Sanmugavel1/SourceSense-atomQUEST2026/cad/renders/SS_Render_Lid_Closeup.png

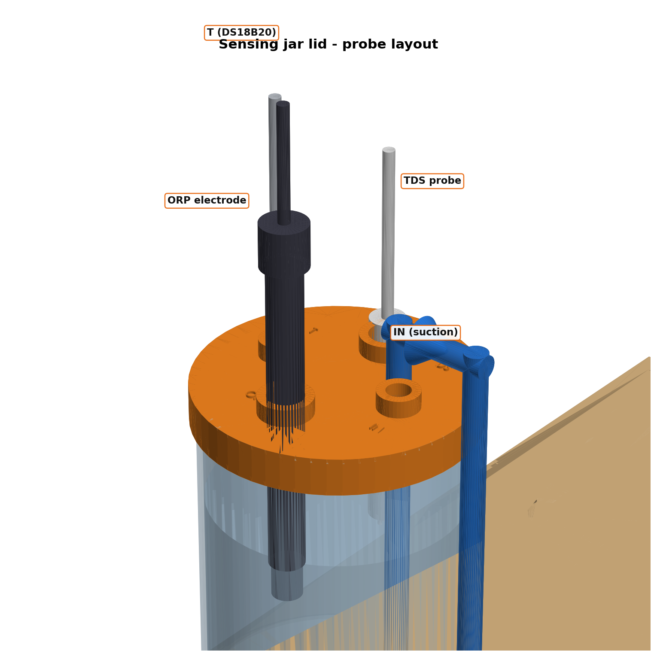
cad/renders/SS_Render_Lid_Closeup.png
