Sanmugavel1/SourceSense-atomQUEST2026/cad/renders/SS_Render_Overall_Iso.png

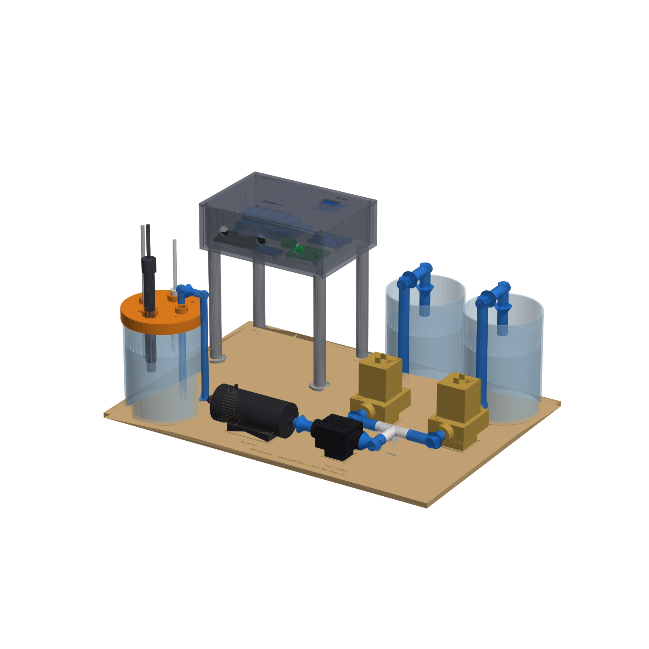
cad/renders/SS_Render_Overall_Iso.png
