Sanmugavel1/SourceSense-atomQUEST2026/cad/renders/SS_Render_Top.png

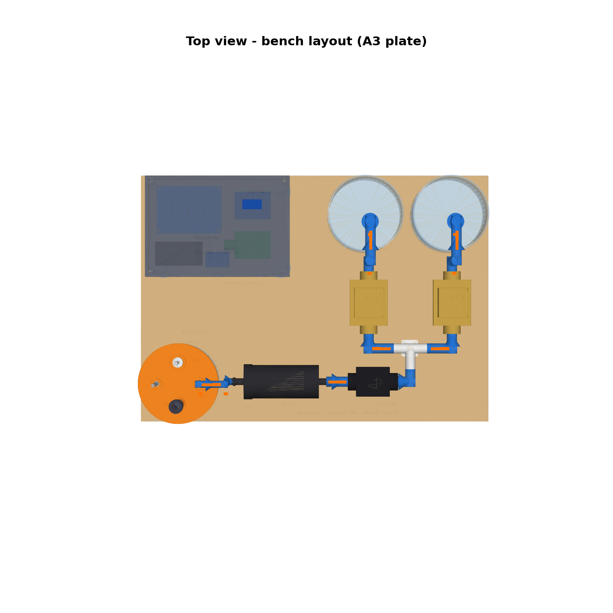
cad/renders/SS_Render_Top.png
