Sanmugavel1/SourceSense-atomQUEST2026/cad/renders/SS_Render_Water_Path.png

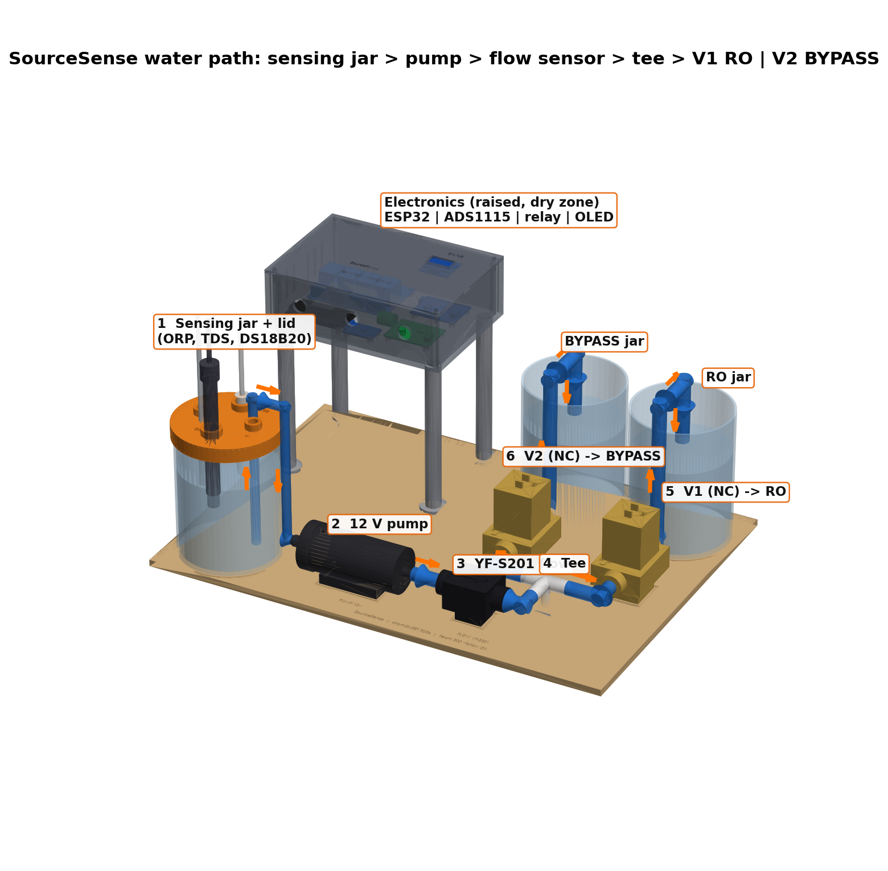
cad/renders/SS_Render_Water_Path.png
