Sanmugavel1/SourceSense-atomQUEST2026/cad/assemblies/SS_11_Assembly_Exploded.SLDASM

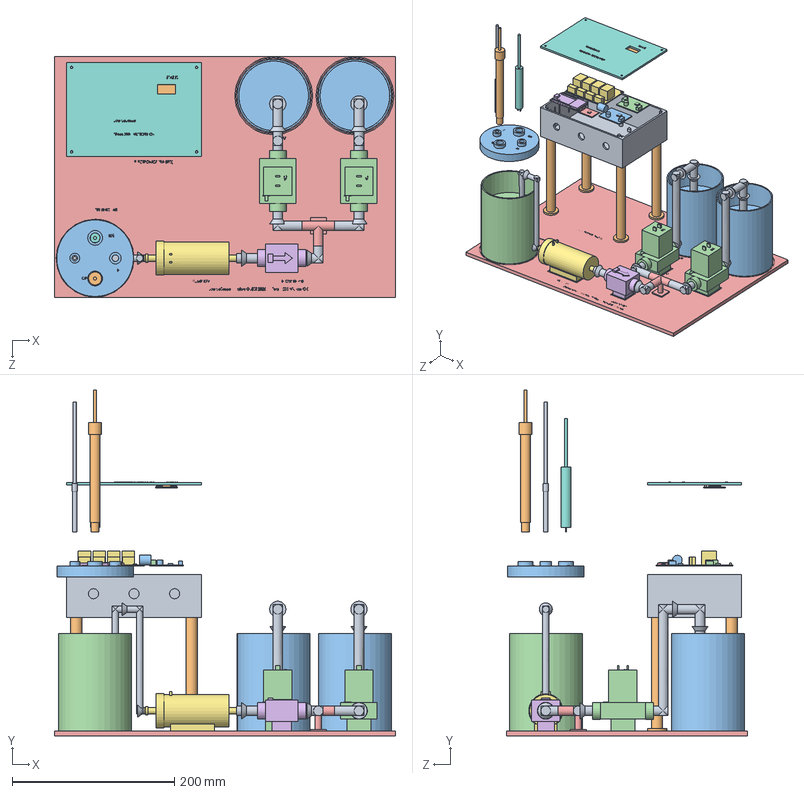
[picture p11: CAD file, 2026-11-04]
cad/assemblies/SS_11_Assembly_Exploded.SLDASM
420.0 x 426.0 x 297.0 mm
SS_09_Base_Plate_A3
SS_00_Sensing_Jar
SS_01_Jar_Lid
SS_11_ORP_Electrode
SS_13_DS18B20_Probe
SS_12_TDS_Probe
SS_02_Pump_12V
SS_03_Flow_Sensor_YF-S201
SS_04_Tee_Connector
SS_05_Solenoid_Valve_NC x 2
SS_06_Output_Jar x 2
SS_08_Standoff_Leg x 4
SS_07_Electronics_Enclosure
SS_07b_Enclosure_Lid
SS_16_Relay_Module_4ch
SS_14_ESP32_DevKit_V1
SS_15_ADS1115_Module
SS_18_TDS_Signal_Board
SS_19_ORP_Signal_Board
SS_17_OLED_096_I2C
SS_20_Water_Tubing
