Sanmugavel1/SourceSense-atomQUEST2026/cad/parts/SS_05_Solenoid_Valve_NC.SLDPRT

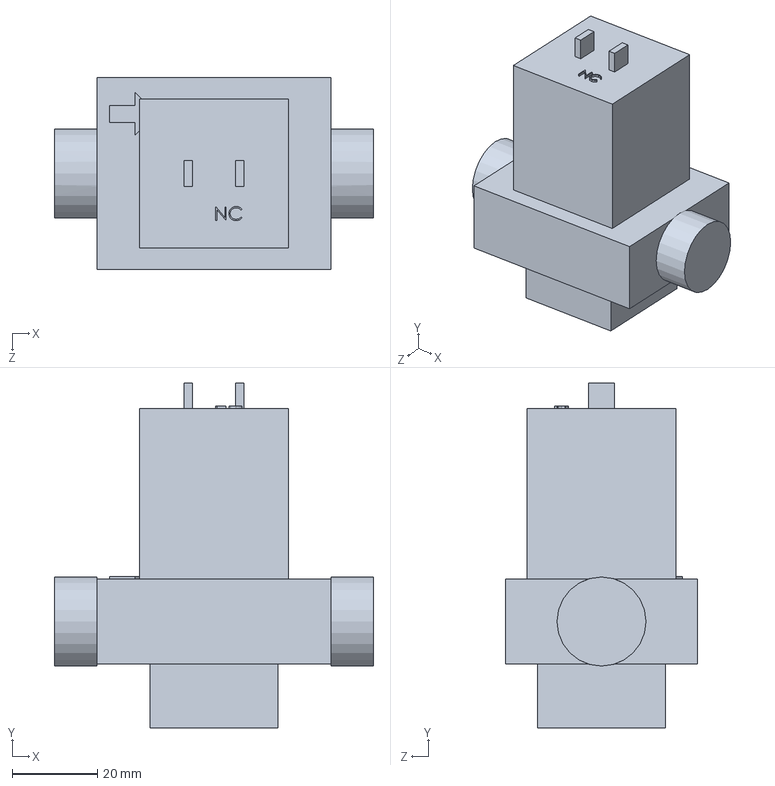
[picture p12: CAD file, 2026-11-04]
cad/parts/SS_05_Solenoid_Valve_NC.SLDPRT
75.0 x 81.0 x 45.0 mm
