Sanmugavel1/SourceSense-atomQUEST2026/cad/parts/SS_04_Tee_Connector.SLDPRT

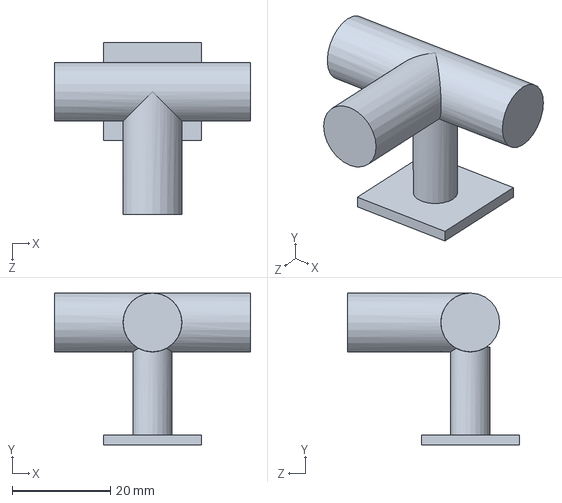
[picture p13: CAD file, 2026-11-04]
cad/parts/SS_04_Tee_Connector.SLDPRT
40.0 x 31.0 x 35.0 mm
