Sanmugavel1/SourceSense-atomQUEST2026/cad/parts/SS_07b_Enclosure_Lid.SLDPRT

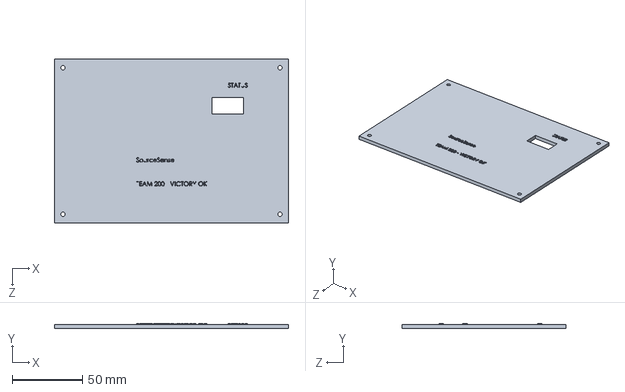
[picture p14: CAD file, 2026-11-04]
cad/parts/SS_07b_Enclosure_Lid.SLDPRT
166.0 x 3.80 x 116.0 mm
