Sanmugavel1/SourceSense-atomQUEST2026/cad/parts/SS_20_Water_Tubing.SLDPRT

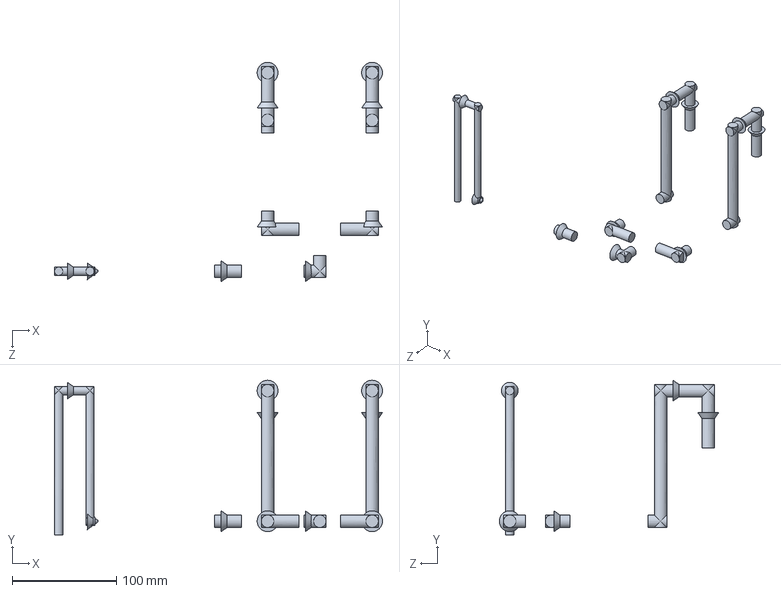
[picture p15: CAD file, 2026-11-04]
cad/parts/SS_20_Water_Tubing.SLDPRT
314.0 x 148.0 x 210.0 mm
