Sanmugavel1/SourceSense-atomQUEST2026/cad/parts/SS_08_Standoff_Leg.SLDPRT

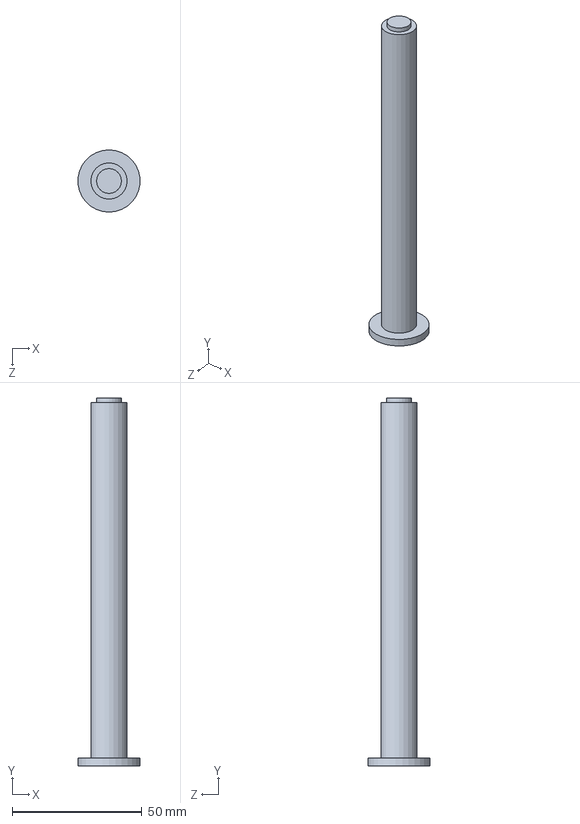
[picture p16: CAD file, 2026-11-04]
cad/parts/SS_08_Standoff_Leg.SLDPRT
23.9 x 141.8 x 24.0 mm
