Sanmugavel1/SourceSense-atomQUEST2026/cad/parts/SS_15_ADS1115_Module.SLDPRT

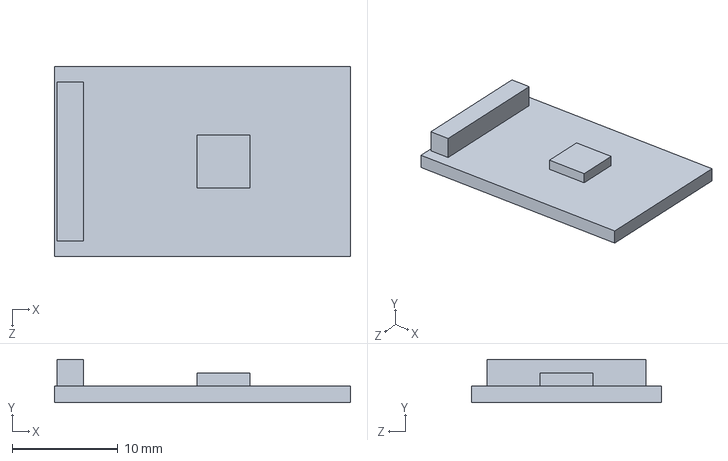
[picture p17: CAD file, 2026-11-04]
cad/parts/SS_15_ADS1115_Module.SLDPRT
28.0 x 4.10 x 18.0 mm
