Sanmugavel1/SourceSense-atomQUEST2026/cad/parts/SS_11_ORP_Electrode.SLDPRT

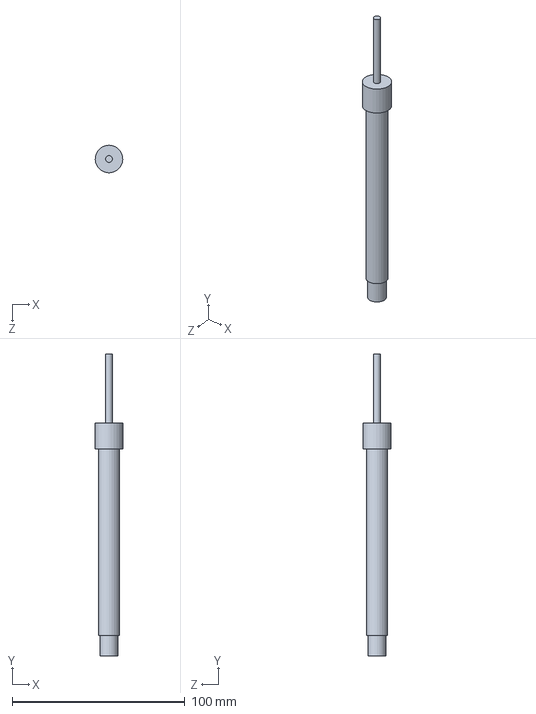
[picture p18: CAD file, 2026-11-04]
cad/parts/SS_11_ORP_Electrode.SLDPRT
16.0 x 175.0 x 16.0 mm
