Sanmugavel1/SourceSense-atomQUEST2026/cad/parts/SS_19_ORP_Signal_Board.SLDPRT

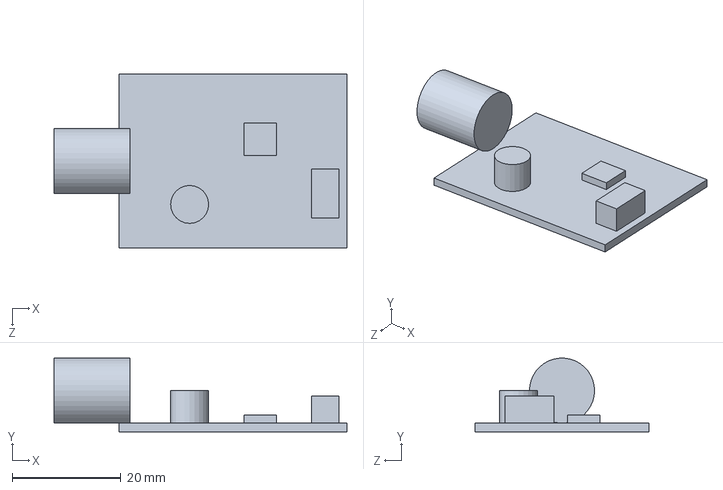
[picture p19: CAD file, 2026-11-04]
cad/parts/SS_19_ORP_Signal_Board.SLDPRT
54.0 x 13.6 x 32.0 mm
