Sanmugavel1/SourceSense-atomQUEST2026/cad/parts/SS_16_Relay_Module_4ch.SLDPRT

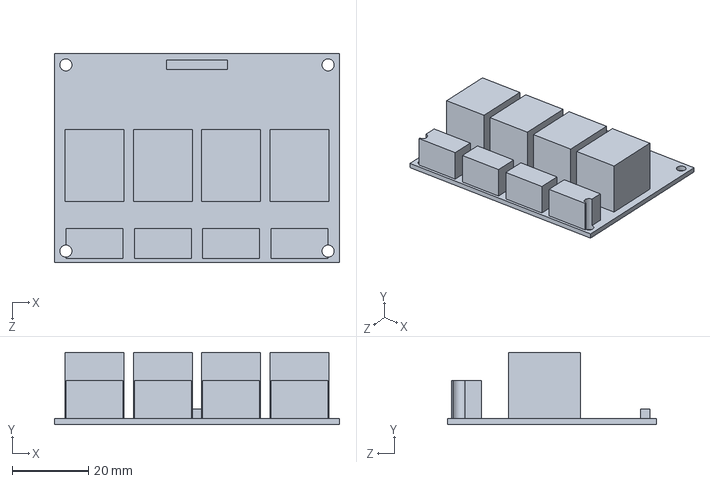
[picture p20: CAD file, 2026-11-04]
cad/parts/SS_16_Relay_Module_4ch.SLDPRT
75.0 x 19.0 x 55.0 mm
