Sanmugavel1/SourceSense-atomQUEST2026/cad/parts/SS_18_TDS_Signal_Board.SLDPRT

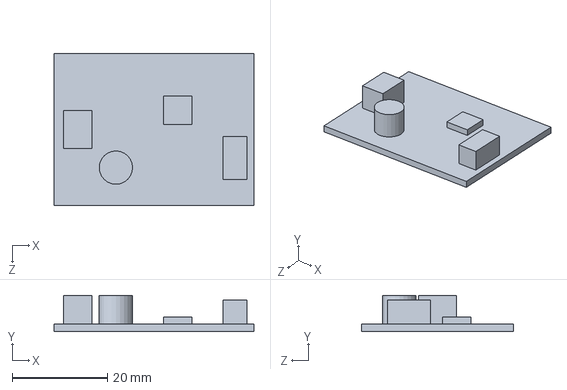
[picture p21: CAD file, 2026-11-04]
cad/parts/SS_18_TDS_Signal_Board.SLDPRT
42.0 x 7.60 x 32.0 mm
