Sanmugavel1/SourceSense-atomQUEST2026/cad/parts/SS_12_TDS_Probe.SLDPRT

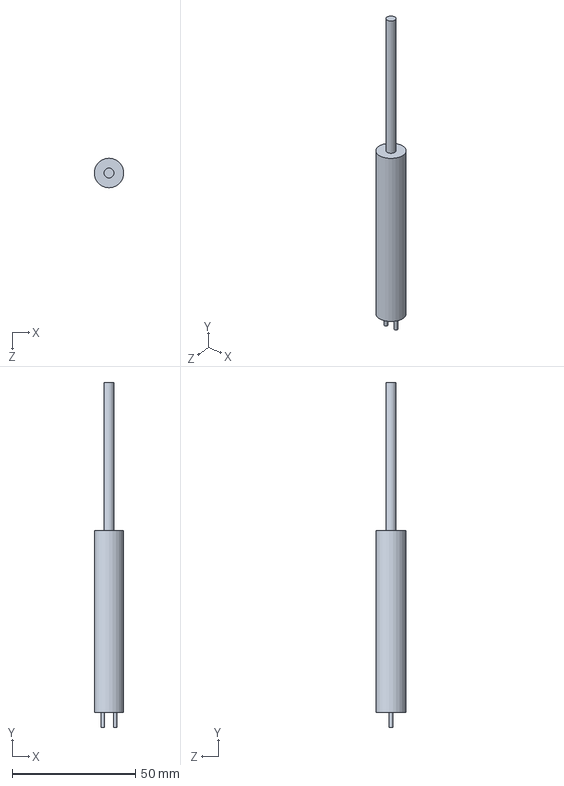
[picture p22: CAD file, 2026-11-04]
cad/parts/SS_12_TDS_Probe.SLDPRT
11.9 x 140.0 x 12.0 mm
