Sanmugavel1/SourceSense-atomQUEST2026/cad/parts/SS_07_Electronics_Enclosure.SLDPRT

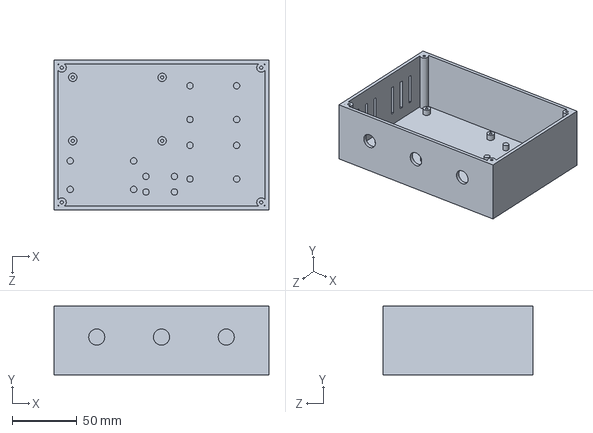
[picture p23: CAD file, 2026-11-04]
cad/parts/SS_07_Electronics_Enclosure.SLDPRT
166.0 x 53.0 x 116.0 mm
