Sanmugavel1/SourceSense-atomQUEST2026/cad/parts/SS_09_Base_Plate_A3.SLDPRT

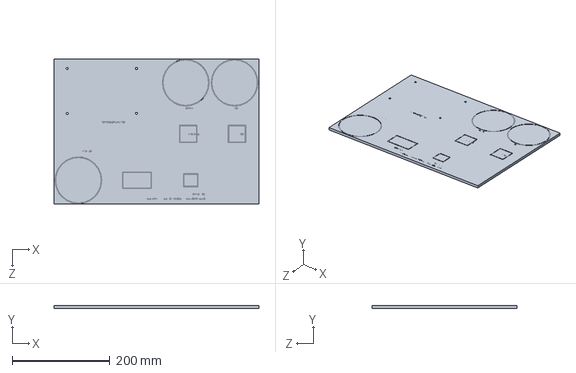
[picture p24: CAD file, 2026-11-04]
cad/parts/SS_09_Base_Plate_A3.SLDPRT
420.0 x 6.00 x 297.0 mm
