Sanmugavel1/SourceSense-atomQUEST2026/cad/parts/SS_06_Output_Jar.SLDPRT

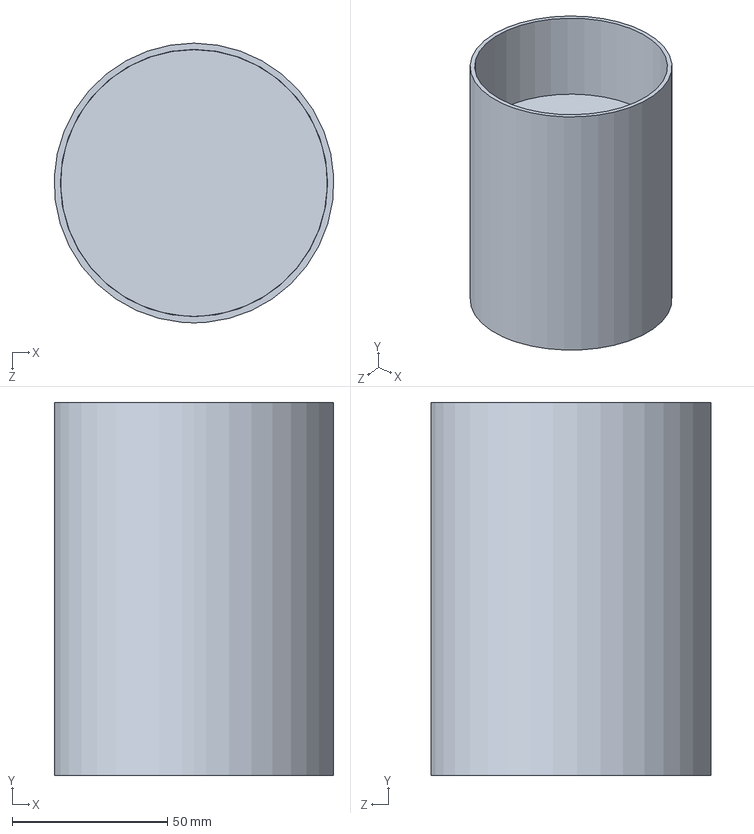
[picture p25: CAD file, 2026-11-04]
cad/parts/SS_06_Output_Jar.SLDPRT
89.9 x 120.0 x 90.0 mm
