Sanmugavel1/SourceSense-atomQUEST2026/cad/parts/SS_14_ESP32_DevKit_V1.SLDPRT

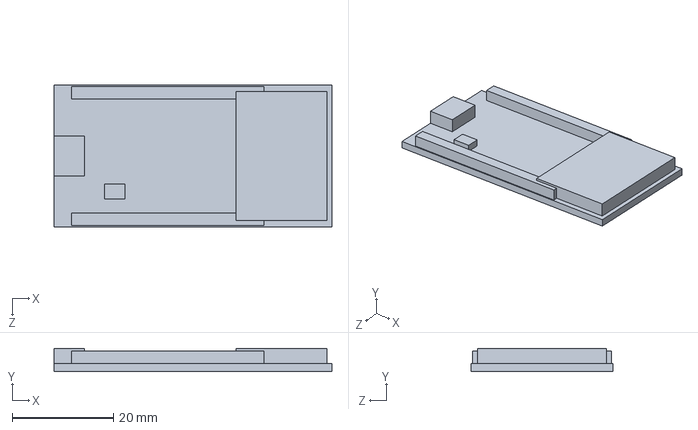
[picture p26: CAD file, 2026-11-04]
cad/parts/SS_14_ESP32_DevKit_V1.SLDPRT
55.0 x 4.60 x 28.0 mm
