Sanmugavel1/SourceSense-atomQUEST2026/cad/parts/SS_01_Jar_Lid.SLDPRT

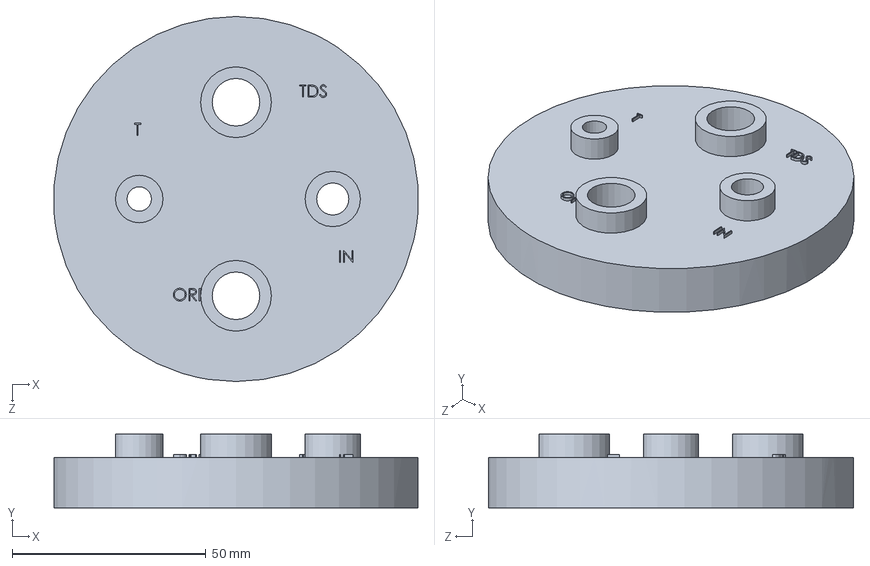
[picture p27: CAD file, 2026-11-04]
cad/parts/SS_01_Jar_Lid.SLDPRT
94.0 x 19.0 x 94.3 mm
