Sanmugavel1/SourceSense-atomQUEST2026/cad/parts/SS_13_DS18B20_Probe.SLDPRT

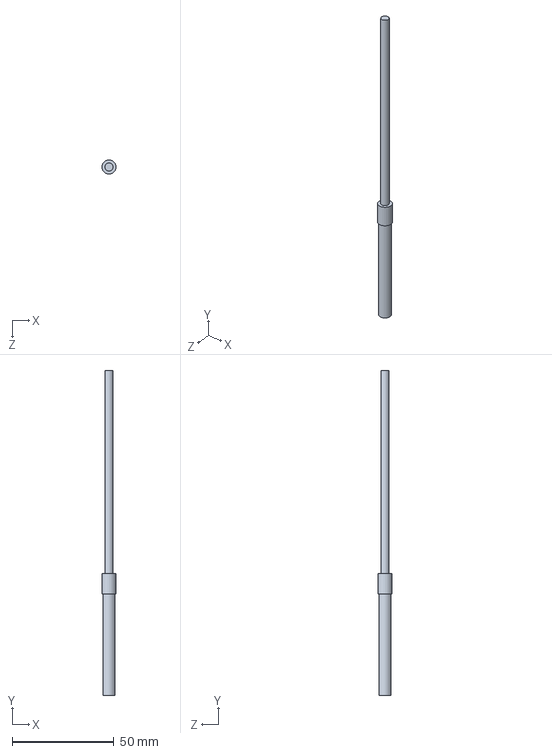
[picture p28: CAD file, 2026-11-04]
cad/parts/SS_13_DS18B20_Probe.SLDPRT
7.00 x 160.0 x 7.00 mm
