Sanmugavel1/SourceSense-atomQUEST2026/cad/parts/SS_03_Flow_Sensor_YF-S201.SLDPRT

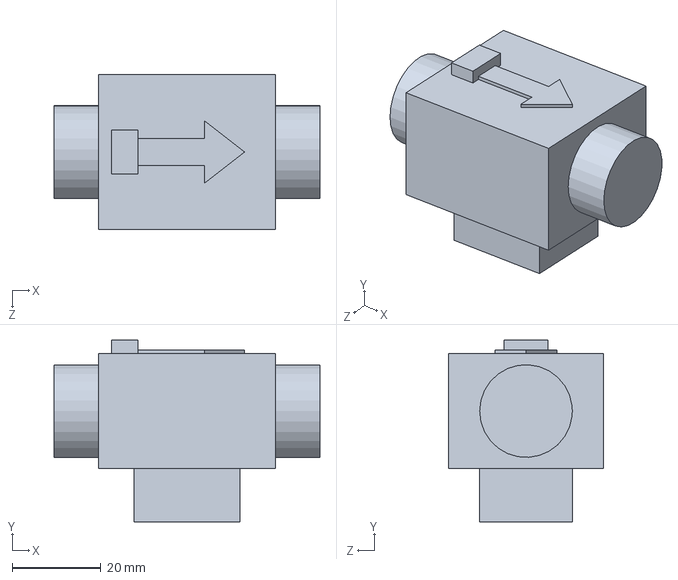
[picture p29: CAD file, 2026-11-04]
cad/parts/SS_03_Flow_Sensor_YF-S201.SLDPRT
60.0 x 41.0 x 35.0 mm
