Sanmugavel1/SourceSense-atomQUEST2026/cad/parts/SS_02_Pump_12V.SLDPRT

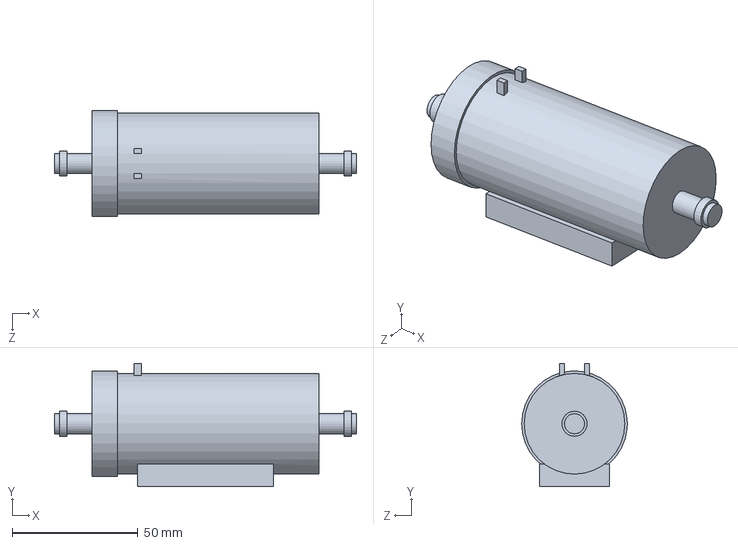
[picture p30: CAD file, 2026-11-04]
cad/parts/SS_02_Pump_12V.SLDPRT
120.0 x 49.0 x 42.0 mm
