Sanmugavel1/SourceSense-atomQUEST2026/cad/parts/SS_17_OLED_096_I2C.SLDPRT

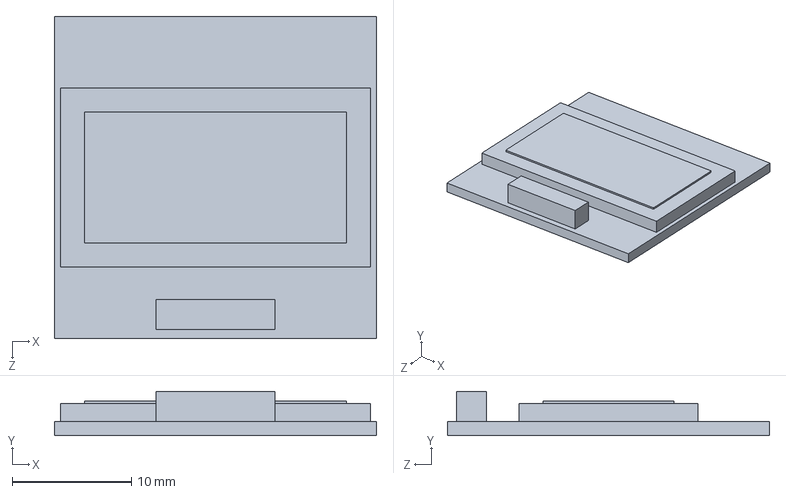
[picture p31: CAD file, 2026-11-04]
cad/parts/SS_17_OLED_096_I2C.SLDPRT
27.0 x 3.70 x 27.0 mm
