Sanmugavel1/SourceSense-atomQUEST2026/(list of files, cad)

Other CAD files:
cad/SS_10_Assembly.step
cad/parts/SS_00_Sensing_Jar.SLDPRT
cad/drawings/SS_10_Assembly.SLDDRW
cad/stl/SS_00_Sensing_Jar.STL
cad/stl/SS_01_Jar_Lid.STL
cad/stl/SS_02_Pump_12V.STL
cad/stl/SS_03_Flow_Sensor_YF-S201.STL
cad/stl/SS_04_Tee_Connector.STL
cad/stl/SS_05_Solenoid_Valve_NC.STL
cad/stl/SS_06_Output_Jar.STL
cad/stl/SS_07_Electronics_Enclosure.STL
cad/stl/SS_07b_Enclosure_Lid.STL
cad/stl/SS_08_Standoff_Leg.STL
cad/stl/SS_09_Base_Plate_A3.STL
cad/stl/SS_11_ORP_Electrode.STL
cad/stl/SS_12_TDS_Probe.STL
cad/stl/SS_13_DS18B20_Probe.STL
cad/stl/SS_14_ESP32_DevKit_V1.STL
cad/stl/SS_15_ADS1115_Module.STL
cad/stl/SS_16_Relay_Module_4ch.STL
cad/stl/SS_17_OLED_096_I2C.STL
cad/stl/SS_18_TDS_Signal_Board.STL
cad/stl/SS_19_ORP_Signal_Board.STL
cad/stl/SS_20_Water_Tubing.STL
