Sanmugavel1/SourceSense-atomQUEST2026/cad/drawings/SS_10_Assembly.pdf

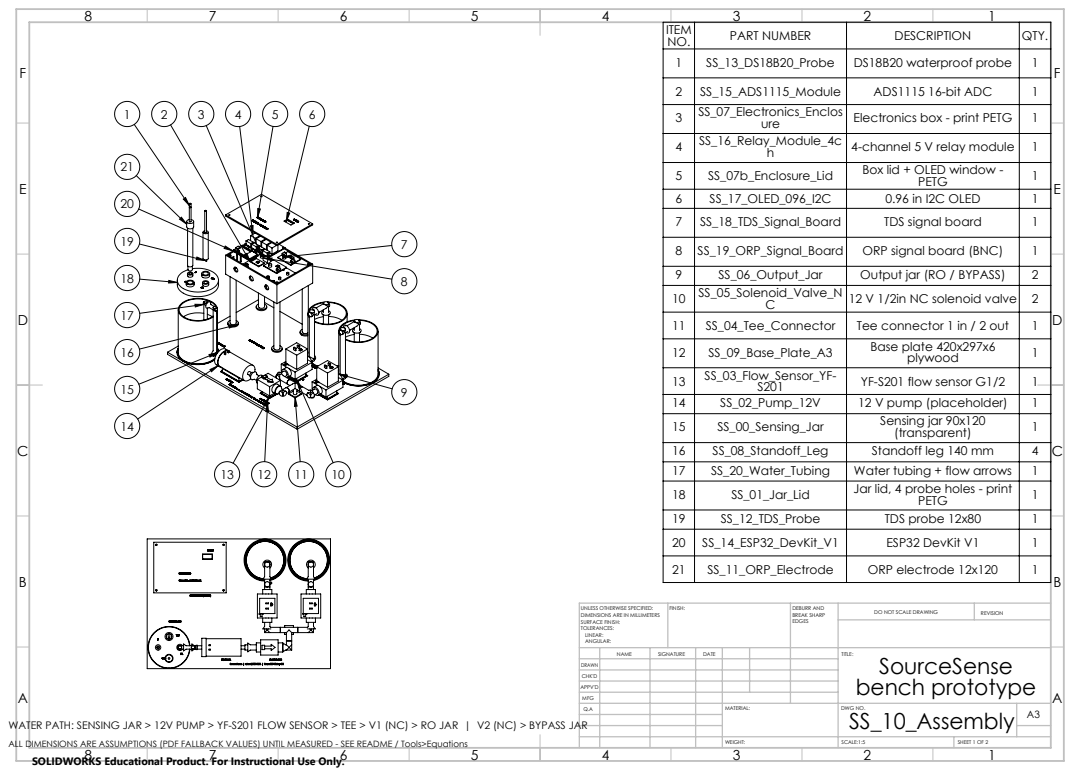
[picture p32: page 1]
FINISH:; DEBURR AND; BREAK SHARP; DO NOT SCALE DRAWING; REVISION; SCALE:1:5; SHEET 1 OF 2

ITEM NO. | PART NUMBER | DESCRIPTION | QTY.

1 | SS_13_DS18B20_Probe | DS18B20 waterproof probe | 1
2 | SS_15_ADS1115_Module | ADS1115 16-bit ADC | 1
3 | SS_07_Electronics_Enclos ure | Electronics box - print PETG | 1
4 | SS_16_Relay_Module_4c h | 4-channel 5 V relay module | 1
5 | SS_07b_Enclosure_Lid | Box lid + OLED window -PETG | 1
6 | SS_17_OLED_096_I2C | 0.96 in I2C OLED | 1
7 | SS_18_TDS_Signal_Board | TDS signal board | 1
8 | SS_19_ORP_Signal_Board | ORP signal board (BNC) | 1
9 | SS_06_Output_Jar | Output jar (RO / BYPASS) | 2
10 | SS_05_Solenoid_Valve_N C | 12 V 1/2in NC solenoid valve | 2

11 | SS_04_Tee_Connector | Tee connector 1 in / 2 out | 1
12 | SS_09_Base_Plate_A3 | Base plate 420x297x6 plywood | 1
13 | SS_03_Flow_Sensor_YF-S201 | YF-S201 flow sensor G1/2 | 1
14 | SS_02_Pump_12V | 12 V pump (placeholder) | 1
15 | SS_00_Sensing_Jar | Sensing jar 90x120 (transparent) | 1
16 | SS_08_Standoff_Leg | Standoff leg 140 mm | 4
17 | SS_20_Water_Tubing | Water tubing + flow arrows | 1
18 | SS_01_Jar_Lid | Jar lid, 4 probe holes - print PETG | 1
19 | SS_12_TDS_Probe | TDS probe 12x80 | 1
20 | SS_14_ESP32_DevKit_V1 | ESP32 DevKit V1 | 1
21 | SS_11_ORP_Electrode | ORP electrode 12x120 | 1

UNLESS OTHERWISE SPECIFIED:
DIMENSIONS ARE IN MILLIMETERS
SURFACE FINISH:
TOLERANCES:
LINEAR:
ANGULAR:

NAME | SIGNATURE | DATE | | | | TITLE: SourceSense bench prototype

DRAWN
CHK'D
APPV'D
MFG
Q.A | | | | MATERIAL: | DWG NO. SS_10_Assembly | A3

WATER PATH: SENSING JAR > 12V PUMP > YF-S201 FLOW SENSOR > TEE > V1 (NC) > RO JAR | V2 (NC) > BYPASS JAR
ALL DIMENSIONS ARE ASSUMPTIONS (PDF FALLBACK VALUES) UNTIL MEASURED - SEE README / Tools>Equations
SOLIDWORKS Educational Product. For Instructional Use Only.

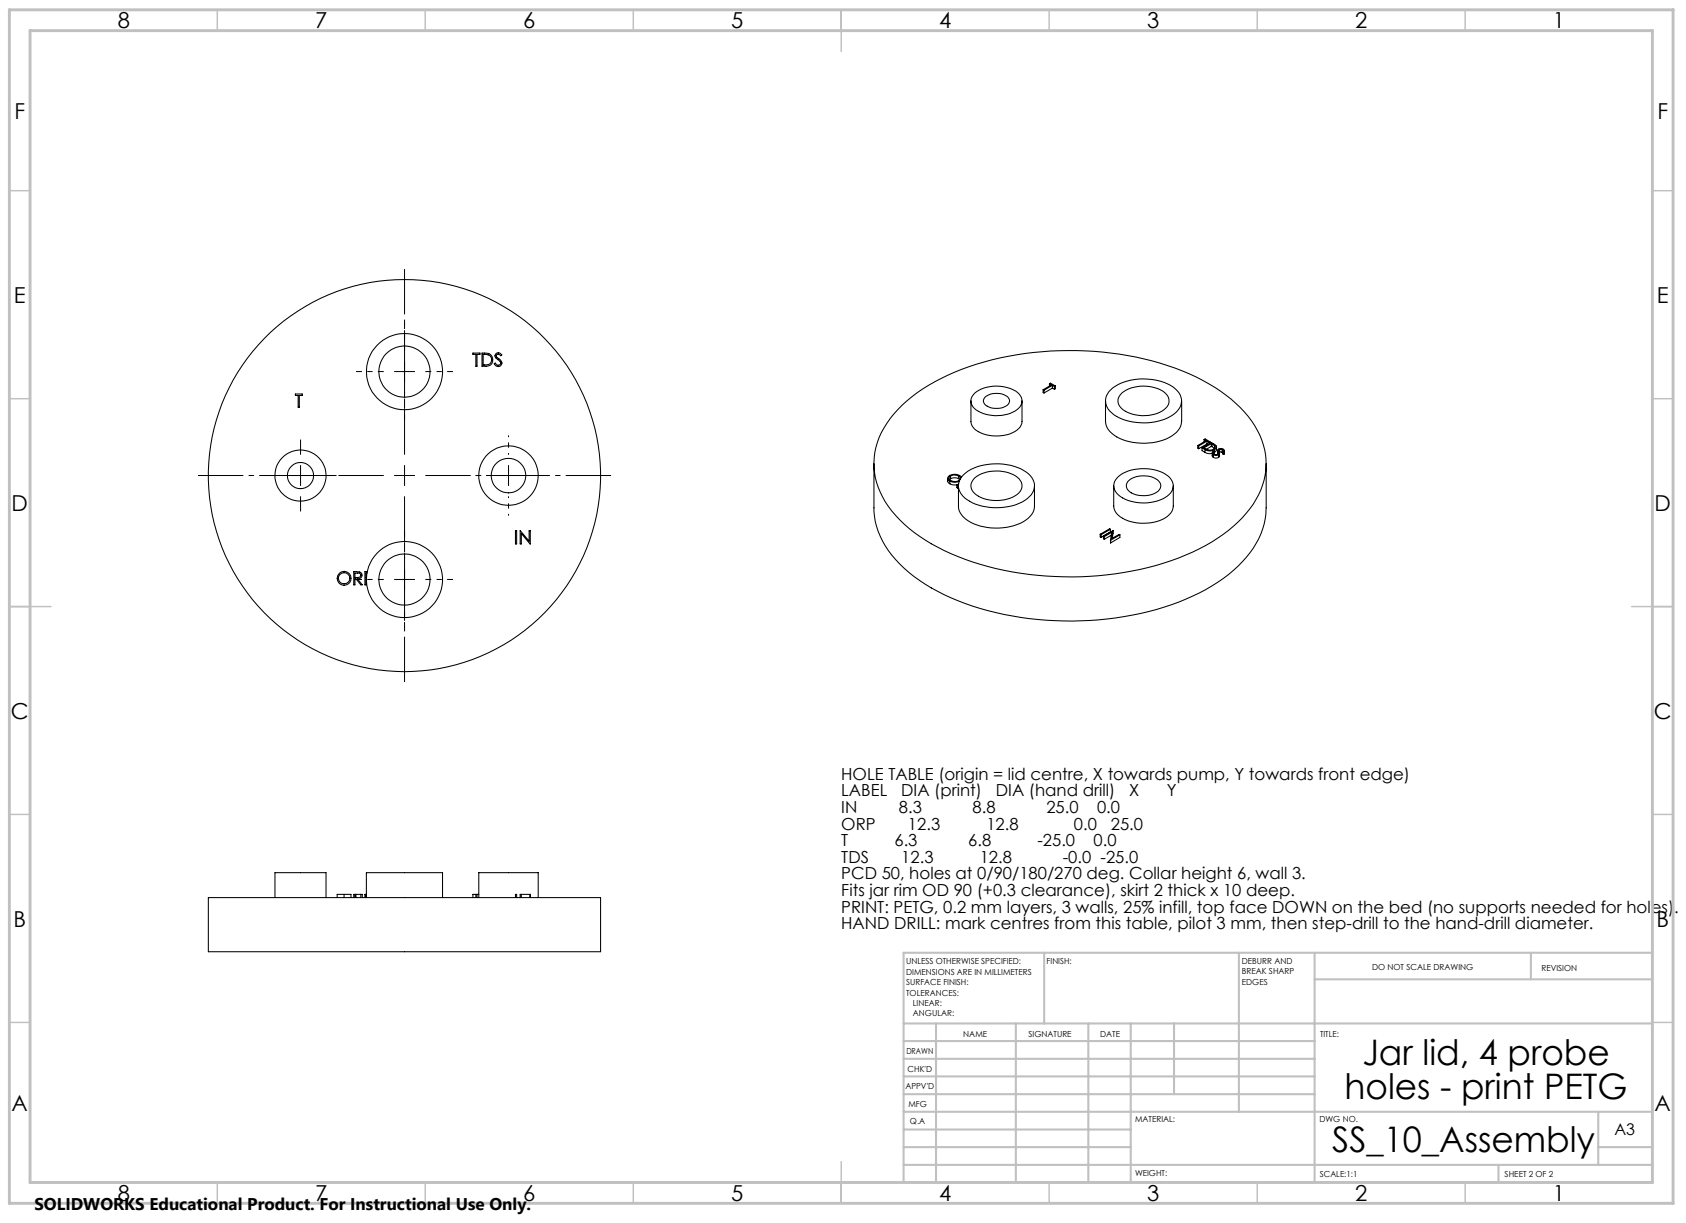
[picture p33: page 2]
LABEL DIA (print) DIA (hand drill) X; ORP; TDS; FINISH:; DEBURR AND; BREAK SHARP; DO NOT SCALE DRAWING; REVISION; SCALE:1:1; SHEET 2 OF 2

HOLE TABLE (origin = lid centre, X towards pump, Y towards front edge)
PCD 50, holes at 0/90/180/270 deg. Collar height 6, wall 3.
Fits jar rim OD 90 (+0.3 clearance), skirt 2 thick x 10 deep.
PRINT: PETG, 0.2 mm layers, 3 walls, 25% infill, top face DOWN on the bed (no supports needed for holes).
HAND DRILL: mark centres from this table, pilot 3 mm, then step-drill to the hand-drill diameter.

UNLESS OTHERWISE SPECIFIED:
DIMENSIONS ARE IN MILLIMETERS
SURFACE FINISH:
TOLERANCES:
LINEAR:
ANGULAR:

NAME | SIGNATURE | DATE | | | | TITLE: Jar lid, 4 probe holes - print PETG

DRAWN
CHK'D
APPV'D
MFG
Q.A | | | | MATERIAL: | DWG NO. SS_10_Assembly | A3

SOLIDWORKS Educational Product. For Instructional Use Only.
