Sanmugavel1/SourceSense-atomQUEST2026/(commit log)

2026-11-04 Add SOLIDWORKS model, drawing and exports
    [SS_00_Sensing_Jar.SLDPRT, SS_00_Sensing_Jar.STL, SS_01_Jar_Lid.SLDPRT, SS_01_Jar_Lid.STL, SS_02_Pump_12V.SLDPRT, SS_02_Pump_12V.STL, SS_03_Flow_Sensor_YF-S201.SLDPRT, SS_03_Flow_Sensor_YF-S201.STL]
2026-11-04 Add ESP32 firmware and Web Serial dashboard
